B0RJA/pomelo/Analysis/gpsLogs/foliumPlots/0.png

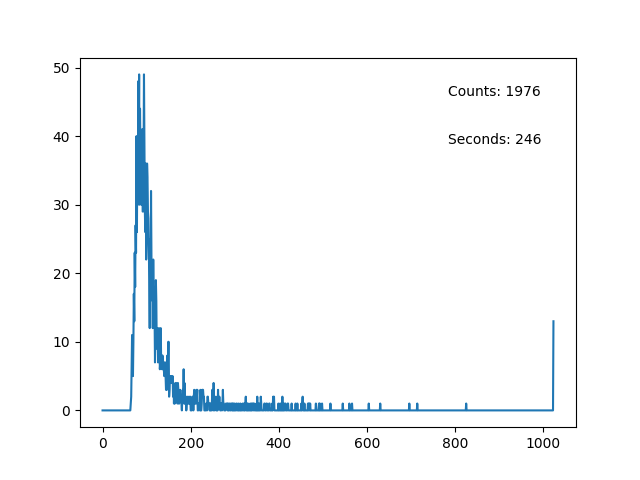
Analysis/gpsLogs/foliumPlots/0.png
