B0RJA/pomelo/Analysis/gpsLogs/foliumPlots/2.png

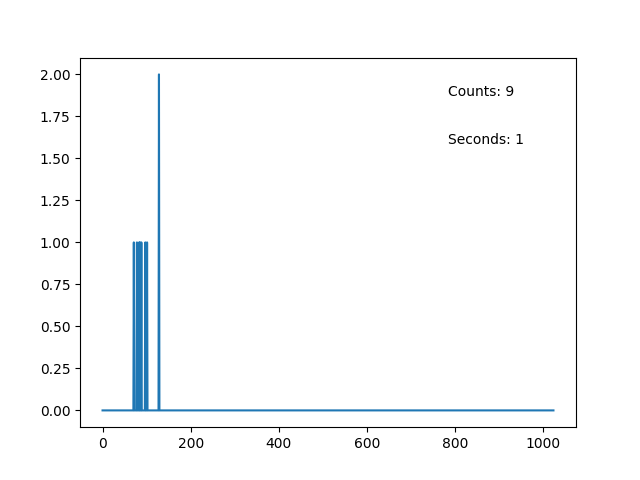
Analysis/gpsLogs/foliumPlots/2.png
