B0RJA/pomelo/Analysis/gpsLogs/foliumPlots/3.png

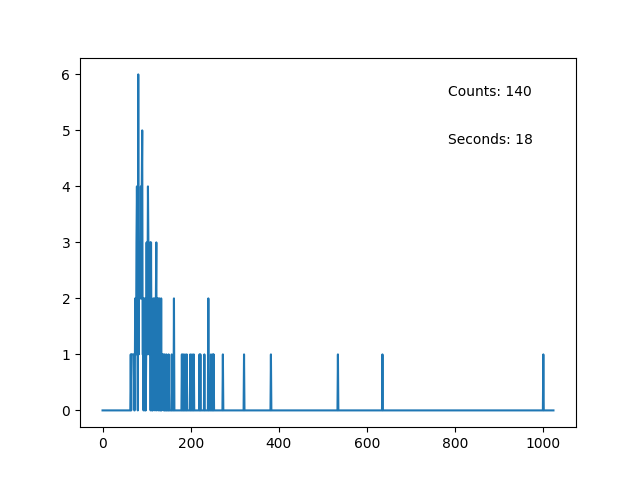
Analysis/gpsLogs/foliumPlots/3.png
