B0RJA/pomelo/Zest/v1_3/firmware/httpFiles/android-chrome-192x192.png

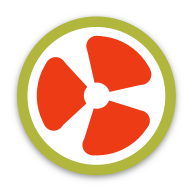
Zest/v1_3/firmware/httpFiles/android-chrome-192x192.png
