B0RJA/pomelo/Zest/v1_3/firmware/httpFiles/mstile-70x70.png

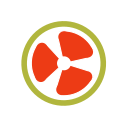
Zest/v1_3/firmware/httpFiles/mstile-70x70.png
