B0RJA/pomelo/Zest/v1_3/firmware/httpFiles/mstile-310x310.png

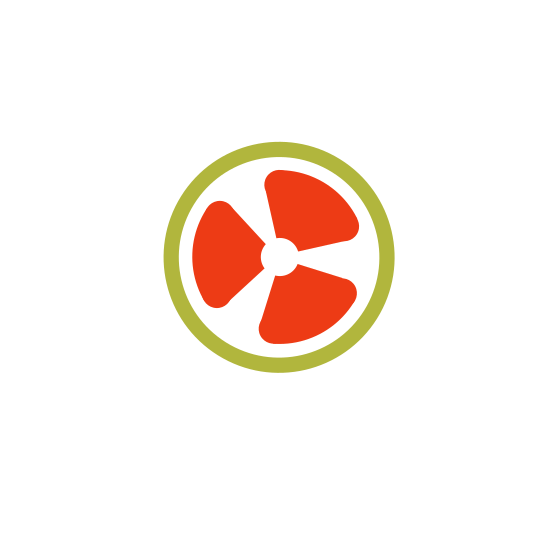
Zest/v1_3/firmware/httpFiles/mstile-310x310.png
