B0RJA/pomelo/Zest/v1_3/hardware/productionFiles/BOM.csv

ID | Name | Designator | Footprint | Quantity | Manufacturer Part | Manufacturer | Supplier | Supplier Part | Price
1 | 1-POINT TEST POINT | TP7,TP1,TP2,TP3 | 1-POINT_TEST-POINT | 4
2 | BSMD0603-050-6V | F1 | F0603 | 1 | BSMD0603-050-6V | BHFUSE(佰宏) | LCSC | C883095 | 0.054
3 | AO3401A | Q8,Q7,Q3,Q1 | SOT-23_L2.9-W1.3-P1.90-LS2.4-BR | 4 | AO3401A | AOS | LCSC | C15127 | 0.061
4 | 10kΩ | R4,R12,R16,R19,R20,R23,R25,R18 | R0603 | 8 | 0603WAF1002T5E | UNI-ROYAL(厚声) | LCSC | C25804 | 0.001
5 | 10uF | C23,C24,C3,C8,C21,C22,C1,C4,C5,C6 | C0603 | 10 | CL10A106KP8NNNC | SAMSUNG(三星) | LCSC | C19702 | 0.006
6 | XC6220B331MR-G | Q6 | SOT-25_L3.0-W1.6-P0.95-LS2.8-TL | 1 | XC6220B331MR-G | TOREX(特瑞仕) | LCSC | C86534 | 0.446
7 | 1kΩ | R3,R10,R15,R17,R8,R21,R22,R24 | R0603 | 8 | 0603WAF1001T5E | UNI-ROYAL(厚声) | LCSC | C21190 | 0.001
8 | ESP32-C6-WROOM-1U-N4 | U1 | WIFIM-SMD_28P-L19.2-W18.0-P1.27-TL | 1 | ESP32-C6-WROOM-1U-N4 | null | LCSC | C19272929
9 | SMD-7525-3627-16Ω | BUZZER1 | BUZ-SMD_4P-L7.5-W7.5-BR | 1 | SMD-7525-3627-16Ω | S&S(海旭) | LCSC | C2685546 | 0.3
10 | 3.9kΩ | R9 | R0603 | 1 | 0603WAF3901T5E | UNI-ROYAL(厚声) | LCSC | C23018 | 0.001
11 | 2N7002 | Q2,Q4 | SOT-23-3_L2.9-W1.3-P1.90-LS2.4-BR | 2 | 2N7002 | CJ | LCSC | C8545 | 0.014
12 | 5.1kΩ | R1,R2,R7 | R0603 | 3 | 0603WAF5101T5E | UNI-ROYAL(厚声) | LCSC | C23186 | 0.001
13 | 100nF | C2,C20,C7 | C0603 | 3 | CC0603KRX7R9BB104 | YAGEO(国巨) | LCSC | C14663 | 0.002
14 | 27kΩ | R5 | R0603 | 1 | 0603WAF2702T5E | UNI-ROYAL(厚声) | LCSC | C22967 | 0.001
15 | 4.7nF | C10 | C0603 | 1 | 0603B472K500NT | FH(风华) | LCSC | C53987 | 0.003
16 | 1MΩ | R6 | R0603 | 1 | 0603WAF1004T5E | UNI-ROYAL(厚声) | LCSC | C22935 | 0.001
17 | NHD-C12832A1Z-FSW-FBW-3V3 | LCD1 | NHD-C12832A1Z-FSW-FBW-3V3 | 1 | NHD-C12832A1Z-FSW-FBW-3V3 | Newhaven Display Intl | Digi-Key | NHD-C12832A1Z-FSW-FBW-3V3-ND
18 | 1uF | C9,C11,C12,C13,C14,C15,C16,C17,C18,C19 | C0603 | 10 | CL10A105KB8NNNC | SAMSUNG(三星) | LCSC | C15849 | 0.005
19 | 1N4148W_C81598 | D3 | SOD-123F_L2.7-W1.6-LS3.8-RD | 1 | 1N4148W | ST(先科) | LCSC | C81598 | 0.011
20 | FMMT491TA | Q5 | SOT-23-3_L2.9-W1.6-P1.90-LS2.8-BR | 1 | FMMT491TA | DIODES(美台) | LCSC | C141788 | 0.047
21 | TS-1187A-B-A-B | BUT4,BUT1,BUT2,BUT3 | SW-SMD_4P-L5.1-W5.1-P3.70-LS6.5-TL-2 | 4 | TS-1187A-B-A-B | XKB Connectivity(中国星坤) | LCSC | C318884 | 0.019
22 | 19-217/GHC-YR1S2/3T | CHG1 | LED0603-RD | 1 | 19-217/GHC-YR1S2/3T | EVERLIGHT(亿光) | LCSC | C72043 | 0.021
23 | MCP73832T-2ACI/OT | U3 | SOT-23-5_L3.0-W1.7-P0.95-LS2.8-BR | 1 | MCP73832T-2ACI/OT | MICROCHIP(美国微芯) | LCSC | C38066 | 0.847
24 | TF-CARD H1.8 | TF1 | TF-SMD_TF-CARD-H1.8 | 1 | TF-CARD H1.8 | SHOU HAN(首韩) | LCSC | C7529389 | 0.058
25 | SS34_C8678 | D1 | SMA_L4.3-W2.6-LS5.2-RD | 1 | SS34 | MDD | LCSC | C8678 | 0.028
26 | NUP2114UCMR6T1G | D2 | TSOP-6_L3.0-W1.5-P0.95-LS2.8-BL | 1 | NUP2114UCMR6T1G | ON Semicon | LCSC | C393373 | 0.329
27 | USB3.1C16PFSMT | USBC1 | USB-C-SMD_TYPE-C-USB-17 | 1 | - | LCSC | LCSC | C167321 | 0.371
28 | 803-87-006-10-001101 | U15 | HDR-TH_6P-P2.54-V-F-R2-C3-S2.54 | 1 | 803-87-006-10-001101 | Preci-Dip | LCSC | C6097596 | 1.035
29 | KH-2.54PH90-1X2P-L13.8 | MEAS1 | HDR-TH_2P-P2.54-H-M_KH-2.54PH90-1X2P-L13.8 | 1 | KH-2.54PH90-1X2P-L13.8 | kinghelm(金航标) | LCSC | C2905424 | 0.022
30 | 1042P | BATT | BAT-SMD_1042P | 1 | 1042P | null | LCSC | C9900018847
31 | KH-2.54PH180-1X5P-L11.5 | H2 | HDR-TH_5P-P2.54-V-M | 1 | KH-2.54PH180-1X5P-L11.5 | kinghelm(金航标) | LCSC | C2932699 | 0.033
