B0RJA/pomelo/Core/v1_3/schematic/PomeloCore.pdf

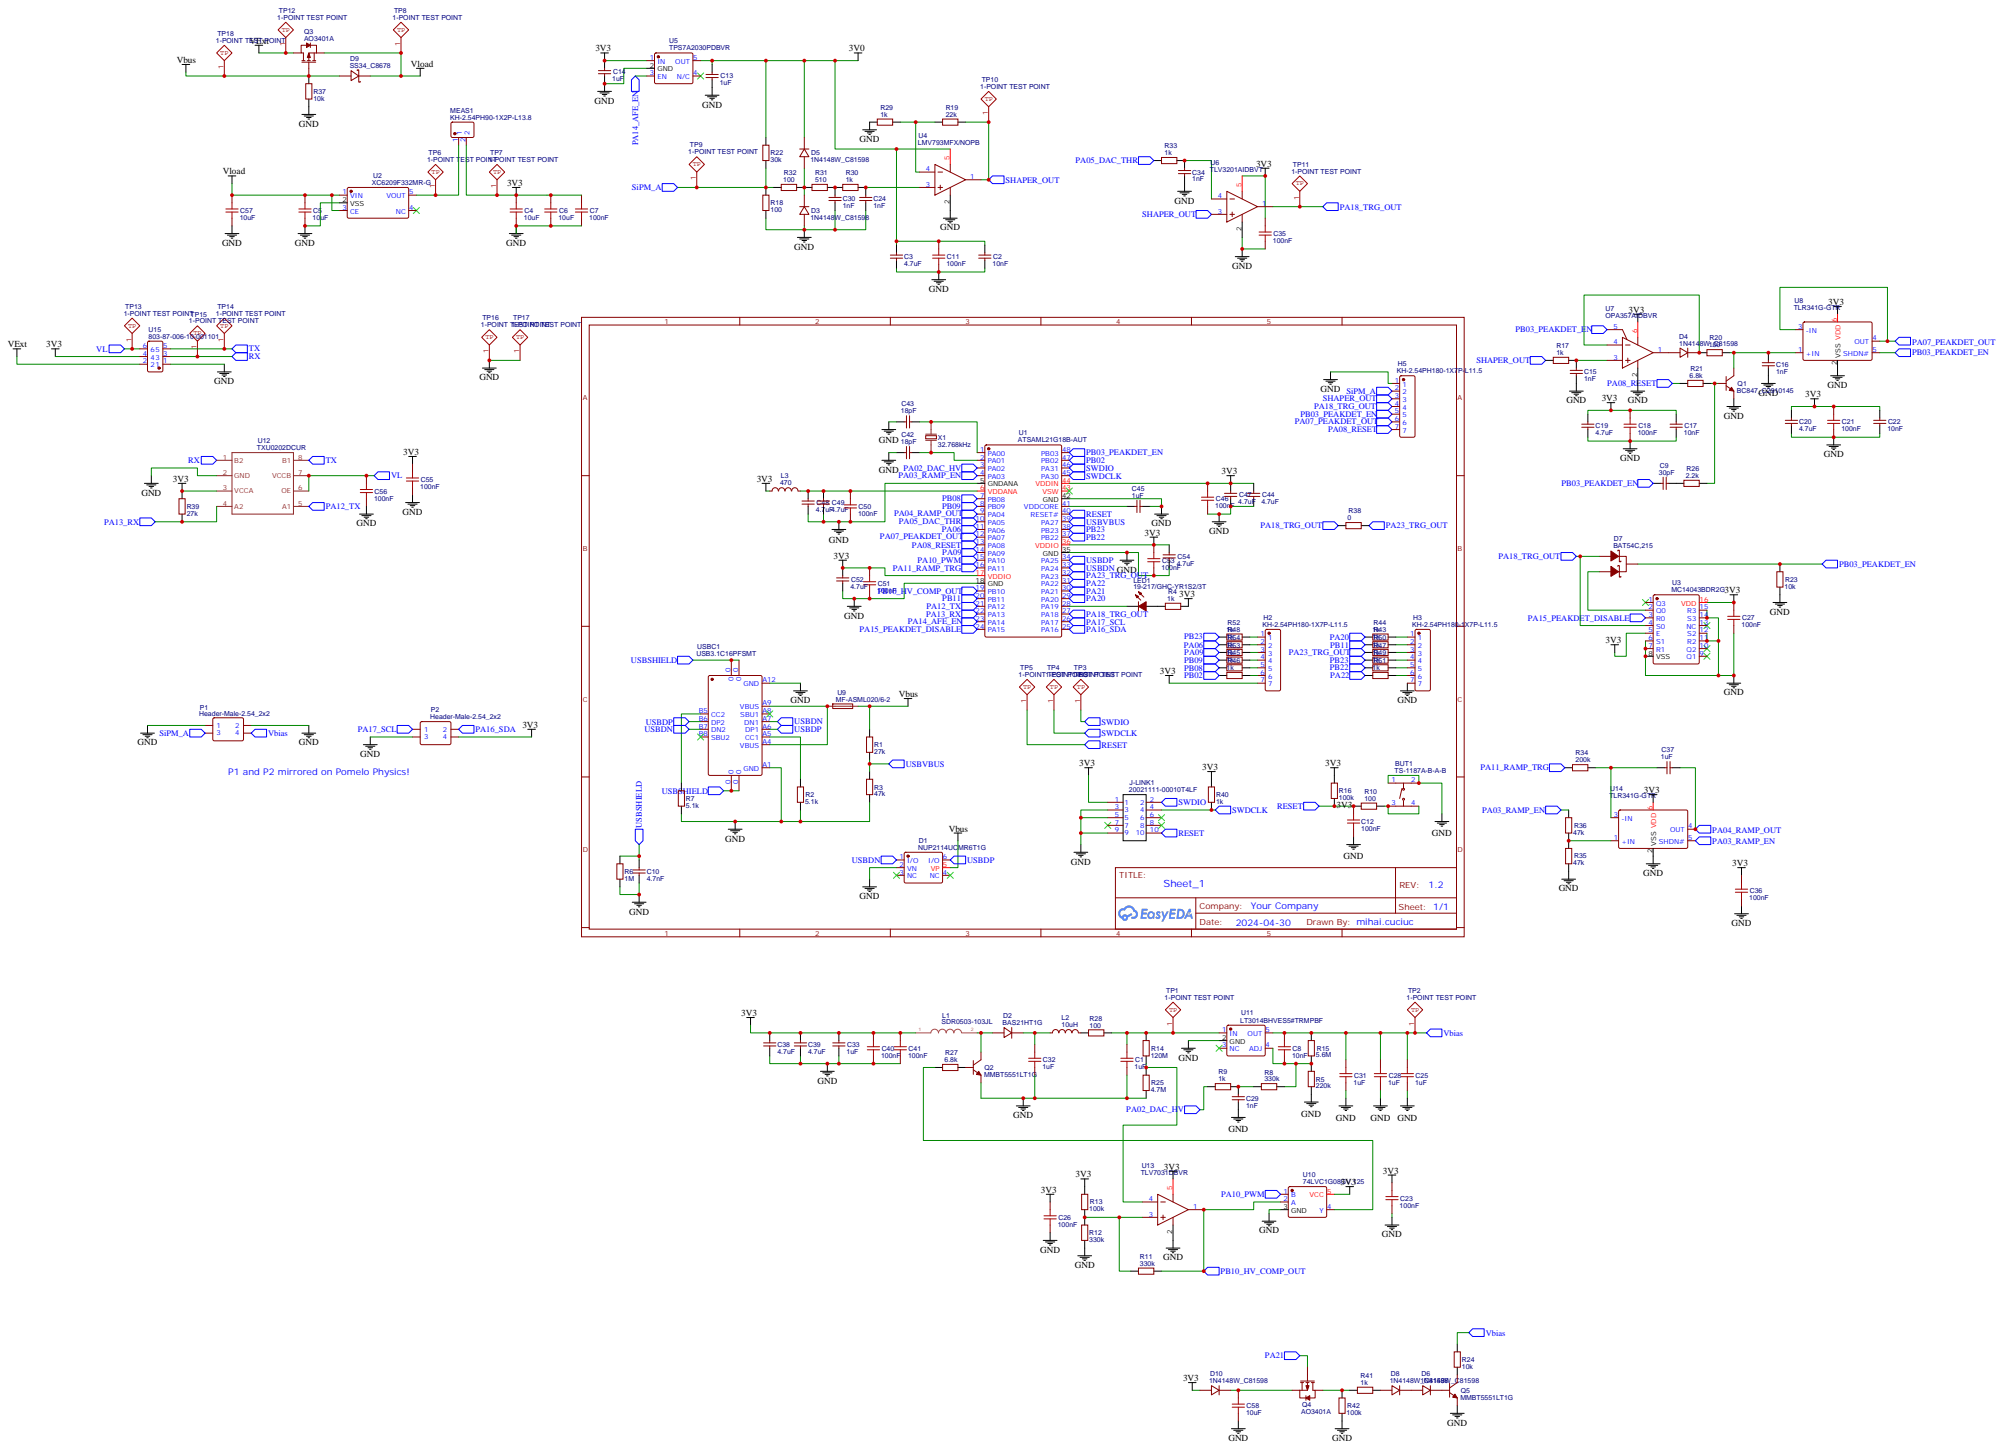
[picture p9: page 1]

P1 and P2 mirrored on Pomelo Physics!

Drawn By: mihai.cuciuc
