B0RJA/pomelo/Core/v1_3/schematic/PomeloPhysics.pdf

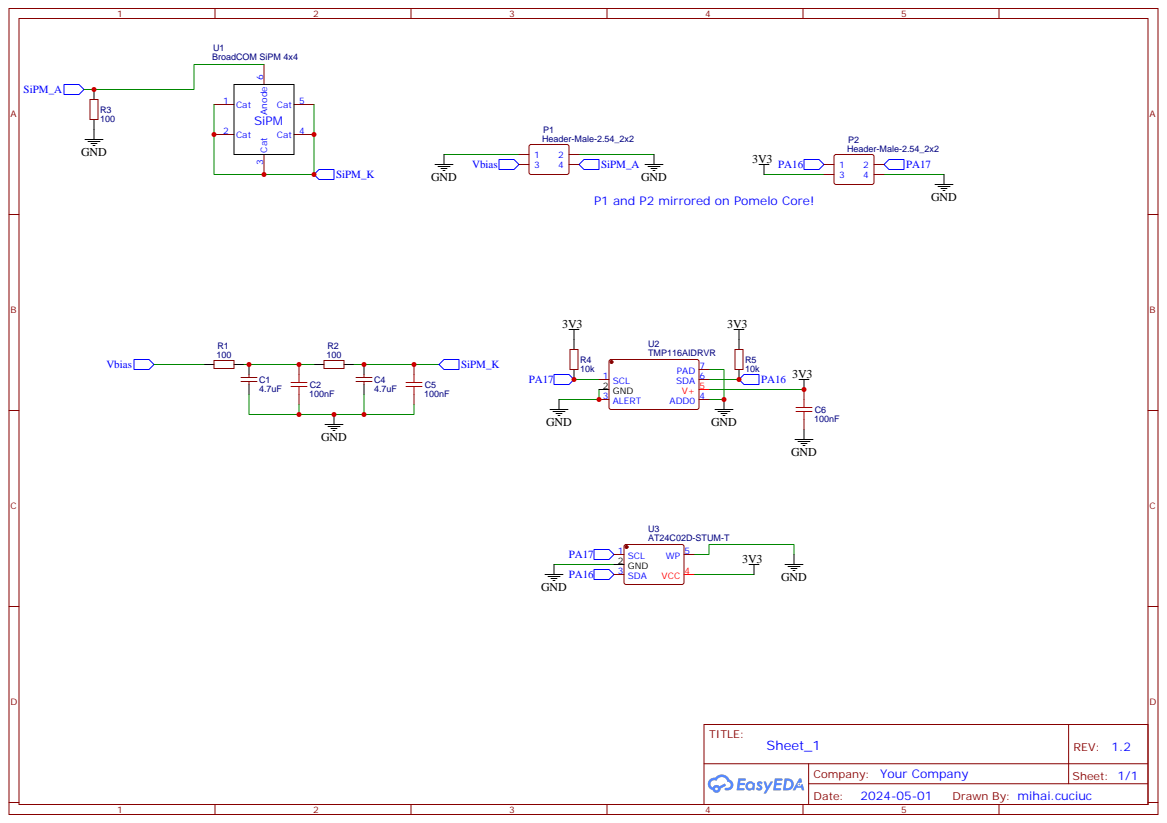
[picture p10: page 1]

P1 and P2 mirrored on Pomelo Core!

Drawn By: mihai.cuciuc
