B0RJA/pomelo/Zest/v1_3/hardware/schematic/PomeloZest.pdf

## U1GND ²⁹

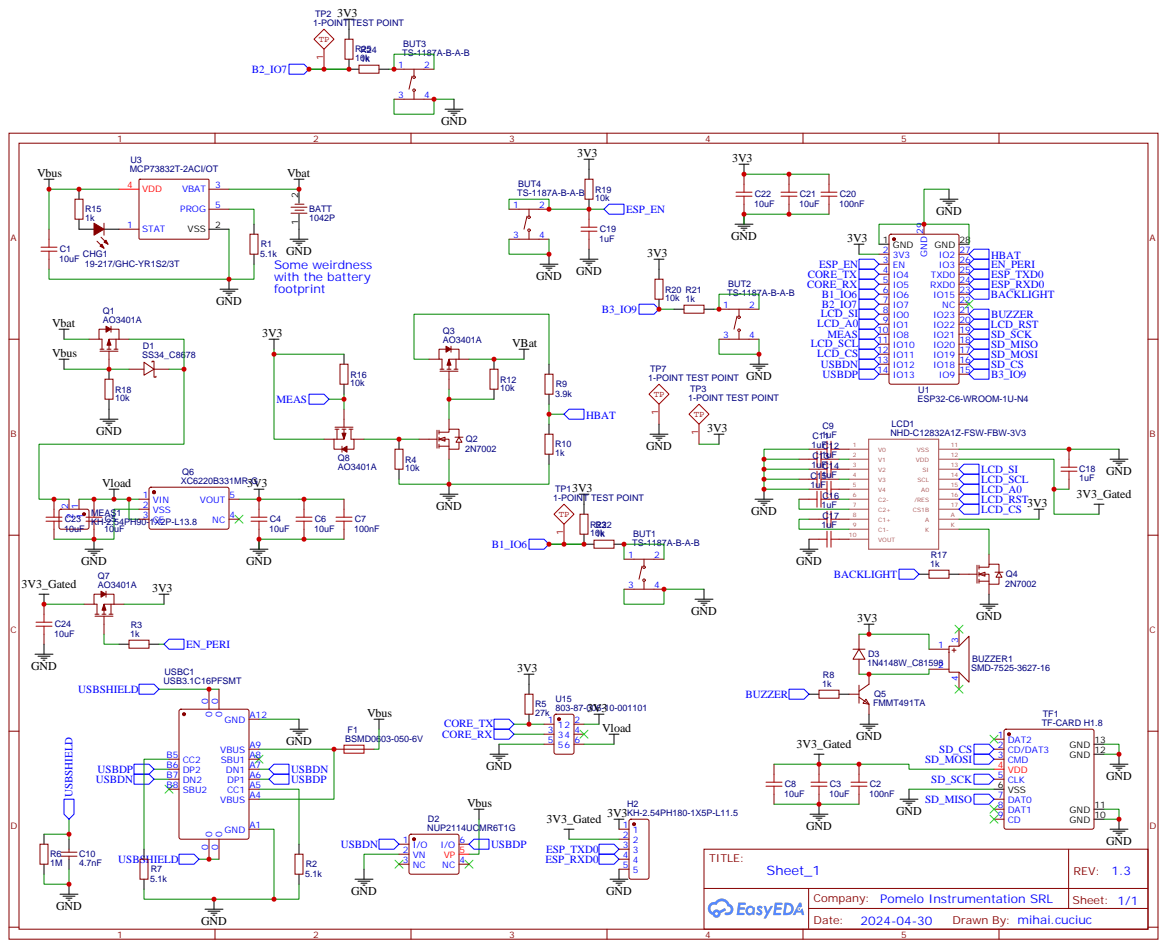
[picture p11: page 1]

4 | | 14
5 | | 15

Company: Pomelo Instrumentation SRL

Drawn By: mihai.cuciuc
