B0RJA/pomelo/(commit log)

2024-09-13 Upload Zest EasyEDA project and production files
    [BOM.csv, PickAndPlace.csv]
2024-09-16 Add Core BOM
    [BOM.csv]
2024-11-04 Overhaul zest and interface
    Split monolithic Zest code into "apps", added functionality, changed communication pattern to better handle buzzer clicks.
    [PomeloZest.ino, app_ble.ino, app_cpm.ino, app_endpoint.ino, app_http.ino, app_info.ino, app_log.ino]
2024-12-02 Added analysis demo for GPS log files
    [00000000.csv, 00000001.csv, 00000002.csv]
2025-08-12 Updated Core & Zest v1.3
    [BOM.csv, PickAndPlace.csv]
2025-08-28 Update README.md with comprehensive serial command documentation
    This commit expands the README.md file to include full documentation for the device's serial communication commands.
    The updates cover:
    Regular Commands: Details on single-character commands for status, configuration, power control, and data retrieval (e.g., histogram, system status, CPM, uSv/h).
    Parameter Setting Commands: A table outlining all configurable parameters with their serial code, name, description, and value range.
    Special Action Commands: A table for commands that trigger specific functions (e.g., save parameters, ADC calibration, system reset, bootloader mode).
    Command Structure: Cl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
